Kurihararyder/tpu-Muon-1/flow/summary_table.md

| 變體 | 資料格式 | 時脈目標 (ns) | 合成面積 (µm²) | 佈局後元件面積 (µm²) | 正反器數 | 核心面積 (µm²) | 內部（暫存器到暫存器）slack (ns) | 內部最高時脈 (MHz) | I/O 路徑 slack (ns) | 總功耗 (mW) |
|---|---|---|---|---|---|---|---|---|---|---|
| 基準 | Q3.13 / 16 位元 | 10 | 40,140.2 | 40,465.5 | 3,213 | 99,710 | 8.088 | 523 | 4.978 | 7.28 |
| 時脈 6 ns | Q3.13 / 16 位元 | 6 | 40,140.2 | 40,457.5 | 3,213 | 99,710 | 4.086 | 522 | 2.538 | 11.63 |
| 時脈 5 ns | Q3.13 / 16 位元 | 5 | 40,140.2 | 40,465.5 | 3,213 | 99,710 | 3.092 | 524 | 2.003 | 13.80 |
| 時脈 4 ns | Q3.13 / 16 位元 | 4 | 40,140.2 | 40,470.6 | 3,213 | 99,710 | 2.102 | 527 | 1.471 | 17.07 |
| 時脈 3 ns | Q3.13 / 16 位元 | 3 | 40,140.2 | 40,475.1 | 3,213 | 99,710 | 1.106 | 528 | 0.966 | 22.65 |
| 時脈 2.5 ns | Q3.13 / 16 位元 | 2.5 | 40,140.2 | 40,468.4 | 3,213 | 99,710 | 0.606 | 528 | 0.741 | 26.91 |
| 時脈 2 ns | Q3.13 / 16 位元 | 2 | 40,140.2 | 40,512.3 | 3,213 | 99,710 | 0.117 | 531 | 0.515 | 33.42 |
| 時脈 1.8 ns | Q3.13 / 16 位元 | 1.8 | 40,140.2 | 40,632.3 | 3,213 | 99,710 | 0.026 | 564 | 0.359 | 37.37 |
| 時脈 1.6 ns | Q3.13 / 16 位元 | 1.6 | 40,140.2 | 41,166.4 | 3,213 | 99,710 | -0.111 | — | 0.240 | 44.36 |
| 位寬 12 | Q3.9 / 12 位元 | 10 | 30,924.4 | 31,196.7 | 2,421 | 77,001 | 8.234 | 566 | 4.766 | 5.76 |
| 位寬 24 | Q3.19 / 24 位元 | 10 | 59,655.3 | 60,116.8 | 4,793 | 148,568 | 7.853 | 466 | 4.837 | 10.27 |
| 位寬 12、時脈 2 ns | Q3.9 / 12 位元 | 2 | 30,924.4 | 31,251.5 | 2,421 | 77,001 | 0.296 | 587 | 0.443 | 26.77 |
| 位寬 24、時脈 2 ns | Q3.19 / 24 位元 | 2 | 59,655.3 | 60,368.2 | 4,793 | 148,568 | 0.034 | 509 | 0.491 | 47.21 |
| 平行 8 lane | Q3.13 / 16 位元 | 10 | 61,465.7 | 61,669.7 | 3,655 | 153,029 | 7.668 | 429 | 4.799 | 8.66 |
| 平行 8 lane、時脈 2 ns | Q3.13 / 16 位元 | 2 | 61,465.7 | 61,963.1 | 3,655 | 153,029 | 0.046 | 512 | 0.447 | 38.94 |
| 平行 8 lane、時脈 1.8 ns | Q3.13 / 16 位元 | 1.8 | 61,465.7 | 63,382.2 | 3,655 | 153,029 | -0.014 | — | 0.375 | 43.48 |
| 平行 8 lane、時脈 1.6 ns | Q3.13 / 16 位元 | 1.6 | 61,465.7 | 64,901.3 | 3,655 | 153,029 | -0.203 | — | 0.244 | 49.77 |
