Kurihararyder/tpu-Muon-1/docs/layout/par_routing.png

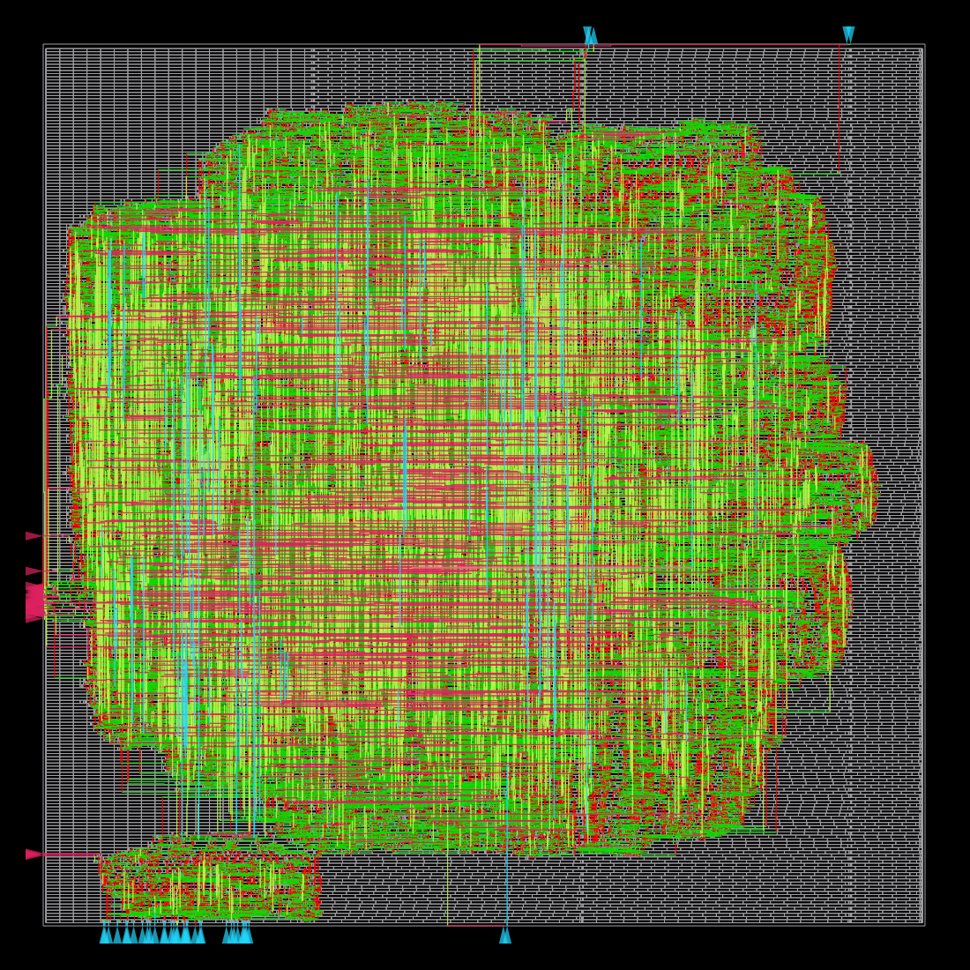
docs/layout/par_routing.png
