Kurihararyder/tpu-Muon-1/docs/waveform_zoom_opa.png

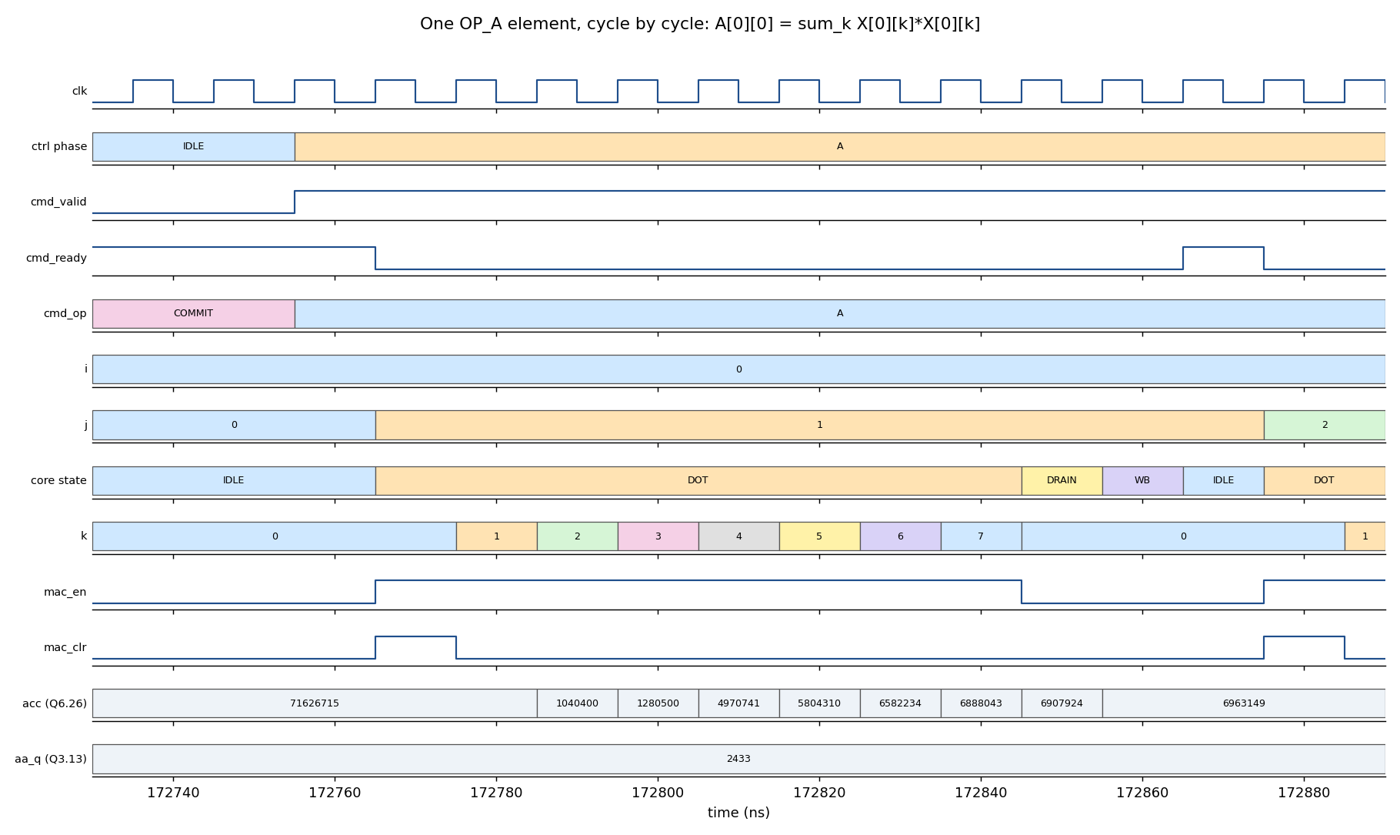
docs/waveform_zoom_opa.png
