Kurihararyder/tpu-Muon-1/docs/format_results.md

# 數值格式評估結果（由 model/format_eval.py 自動產生）

## 特殊輸入檢查

| 格式 | 零矩陣輸出最大絕對值 | 單位矩陣誤差（對黃金模型最大絕對差） |
|---|---|---|
| FP32 | 0.0e+00 | 1.06e-06 |
| bf16 | 0.0e+00 | 6.70e-02 |
| FP16 | 0.0e+00 | 5.62e-04 |
| Q4.12 | 0.0e+00 | 1.39e-03 |
| Q8.8 | 0.0e+00 | 5.62e-04 |
| Q2.14 | 0.0e+00 | 9.33e-01 |
| Q3.13（附加） | 0.0e+00 | 2.93e-04 |

## 各中間值最大範圍（float64，20 組隨機 + 5 組病態矩陣，8x8，5 輪）

| 變數 | 最大絕對值 | 所需整數位（含符號） |
|---|---|---|
| X | 0.895 | 1 |
| A | 1.383 | 2 |
| AA | 1.948 | 2 |
| B | 2.737 | 3 |
| BX | 2.440 | 3 |
| Xnew | 0.939 | 1 |

## 隨機矩陣（20 組 8x8）：各格式對 float64 黃金模型的誤差

| 格式 | 取捨 | 最大絕對誤差 | 平均絕對誤差 | 輸出奇異值範圍 | 儲存飽和次數 |
|---|---|---|---|---|---|
| FP32 | 四捨五入 | 1.42e-06 | 1.92e-07 | 0.506～1.134 | — |
| FP32 | 截斷 | 2.12e-06 | 3.21e-07 | 0.506～1.134 | — |
| bf16 | 四捨五入 | 1.24e-01 | 1.84e-02 | 0.654～1.169 | — |
| bf16 | 截斷 | 1.52e-01 | 2.15e-02 | 0.380～1.151 | — |
| FP16 | 四捨五入 | 1.68e-02 | 2.44e-03 | 0.513～1.133 | — |
| FP16 | 截斷 | 1.52e-02 | 2.42e-03 | 0.513～1.134 | — |
| Q4.12 | 四捨五入 | 4.62e-03 | 7.15e-04 | 0.520～1.134 | 0 |
| Q4.12 | 截斷 | 1.54e-02 | 1.32e-03 | 0.542～1.135 | 0 |
| Q8.8 | 四捨五入 | 8.06e-02 | 1.05e-02 | 0.636～1.138 | 0 |
| Q8.8 | 截斷 | 2.43e-01 | 2.17e-02 | 0.671～1.195 | 0 |
| Q2.14 | 四捨五入 | 2.94e+00 | 1.86e+00 | 0.000～15.919 | 5099 |
| Q2.14 | 截斷 | 2.94e+00 | 1.86e+00 | 0.000～15.910 | 5090 |
| Q3.13（附加） | 四捨五入 | 6.10e-03 | 4.61e-04 | 0.524～1.134 | 0 |
| Q3.13（附加） | 截斷 | 1.38e-02 | 7.80e-04 | 0.545～1.135 | 0 |

## 病態矩陣（5 組，條件數 1e1～1e5）

| 格式 | 取捨 | 最大絕對誤差 | 平均絕對誤差 | 輸出奇異值範圍 | 儲存飽和次數 |
|---|---|---|---|---|---|
| FP32 | 四捨五入 | 4.50e-06 | 5.67e-07 | 0.005～1.155 | — |
| FP32 | 截斷 | 5.56e-06 | 6.45e-07 | 0.005～1.155 | — |
| bf16 | 四捨五入 | 1.92e-01 | 3.49e-02 | 0.102～1.150 | — |
| bf16 | 截斷 | 2.77e-01 | 3.41e-02 | 0.001～1.193 | — |
| FP16 | 四捨五入 | 4.70e-02 | 4.85e-03 | 0.024～1.157 | — |
| FP16 | 截斷 | 3.01e-02 | 4.43e-03 | 0.017～1.163 | — |
| Q4.12 | 四捨五入 | 5.26e-02 | 5.35e-03 | 0.004～1.151 | 0 |
| Q4.12 | 截斷 | 1.36e-01 | 1.36e-02 | 0.011～1.134 | 0 |
| Q8.8 | 四捨五入 | 6.70e-01 | 8.69e-02 | 0.283～1.176 | 0 |
| Q8.8 | 截斷 | 6.48e-01 | 9.79e-02 | 0.046～1.204 | 0 |
| Q2.14 | 四捨五入 | 2.80e+00 | 4.84e-01 | 0.000～13.618 | 316 |
| Q2.14 | 截斷 | 2.80e+00 | 4.80e-01 | 0.000～13.628 | 314 |
| Q3.13（附加） | 四捨五入 | 2.42e-02 | 2.65e-03 | 0.005～1.160 | 0 |
| Q3.13（附加） | 截斷 | 9.81e-02 | 7.52e-03 | 0.006～1.144 | 0 |

## 累加器位寬（定點、四捨五入、隨機 + 病態矩陣）

| 格式 | 累加器位元 | 累加器小數位 | 累加器最大絕對值 | 累加器飽和 | 最大絕對誤差 | 平均絕對誤差 |
|---|---|---|---|---|---|---|
| Q4.12 | 24 | 17 | 2.737 | 0 | 4.99e-02 | 1.57e-03 |
| Q4.12 | 32 | 24 | 2.737 | 0 | 5.26e-02 | 1.64e-03 |
| Q8.8 | 24 | 13 | 2.736 | 0 | 6.51e-01 | 2.51e-02 |
| Q8.8 | 32 | 16 | 2.739 | 0 | 6.70e-01 | 2.58e-02 |
| Q2.14 | 24 | 19 | 32.000 | 1259 | 2.94e+00 | 1.58e+00 |
| Q2.14 | 32 | 27 | 32.000 | 1261 | 2.94e+00 | 1.58e+00 |
| Q3.13（附加） | 24 | 18 | 2.737 | 0 | 2.59e-02 | 9.25e-04 |
| Q3.13（附加） | 32 | 26 | 2.737 | 0 | 2.42e-02 | 8.99e-04 |
